floresacton/slc-control/README.md

# slc-control
Display Controller for SLC Kit Car
