floresacton/slc-control/pcb/design-requirements.txt

altitude(pressure sensor) (LPS22HH)
compass sensor (QMC5883L)
gps (standard module)
2 big mosfet switches (N type positive rail)
eeprom memory
1 speed replicate channel (mosfet pull, optional push)
usb-connection
four regular buttons
corner plated mounting holes (through display)
screen connection
3 sensor channels (voltage divider to internal comparator with hysteresis, DAC input)
screw terminals for connections

speed channel(DAC with buffered output)
3d printed case
External Active Antenna
https://www.amazon.com/Waterproof-Active-Antenna-28dB-3-5VDC/dp/B00LXRQY9A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
