floresacton/slc-control/firmware/resource/slc_true.jpg

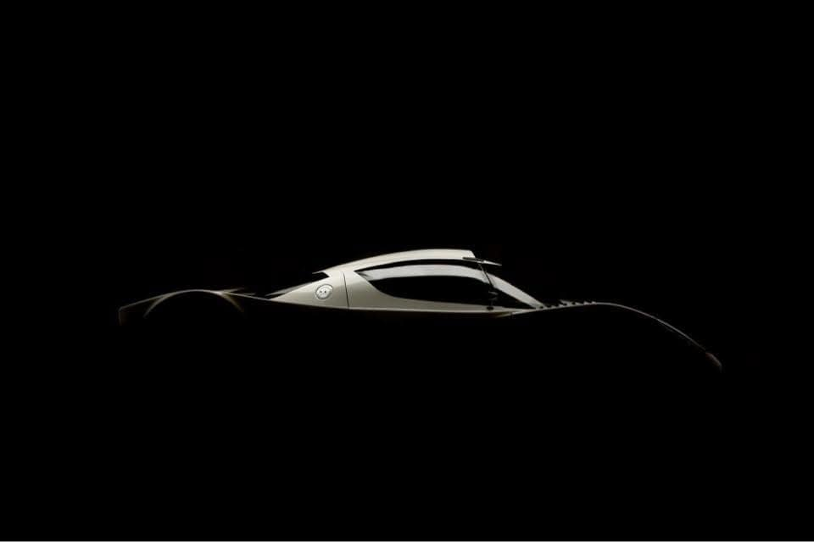
firmware/resource/slc_true.jpg
