floresacton/slc-control/pcb/slc-control.kicad_pcb

## KiCad design pcb/slc-control.kicad_pcb (2025-01-04)

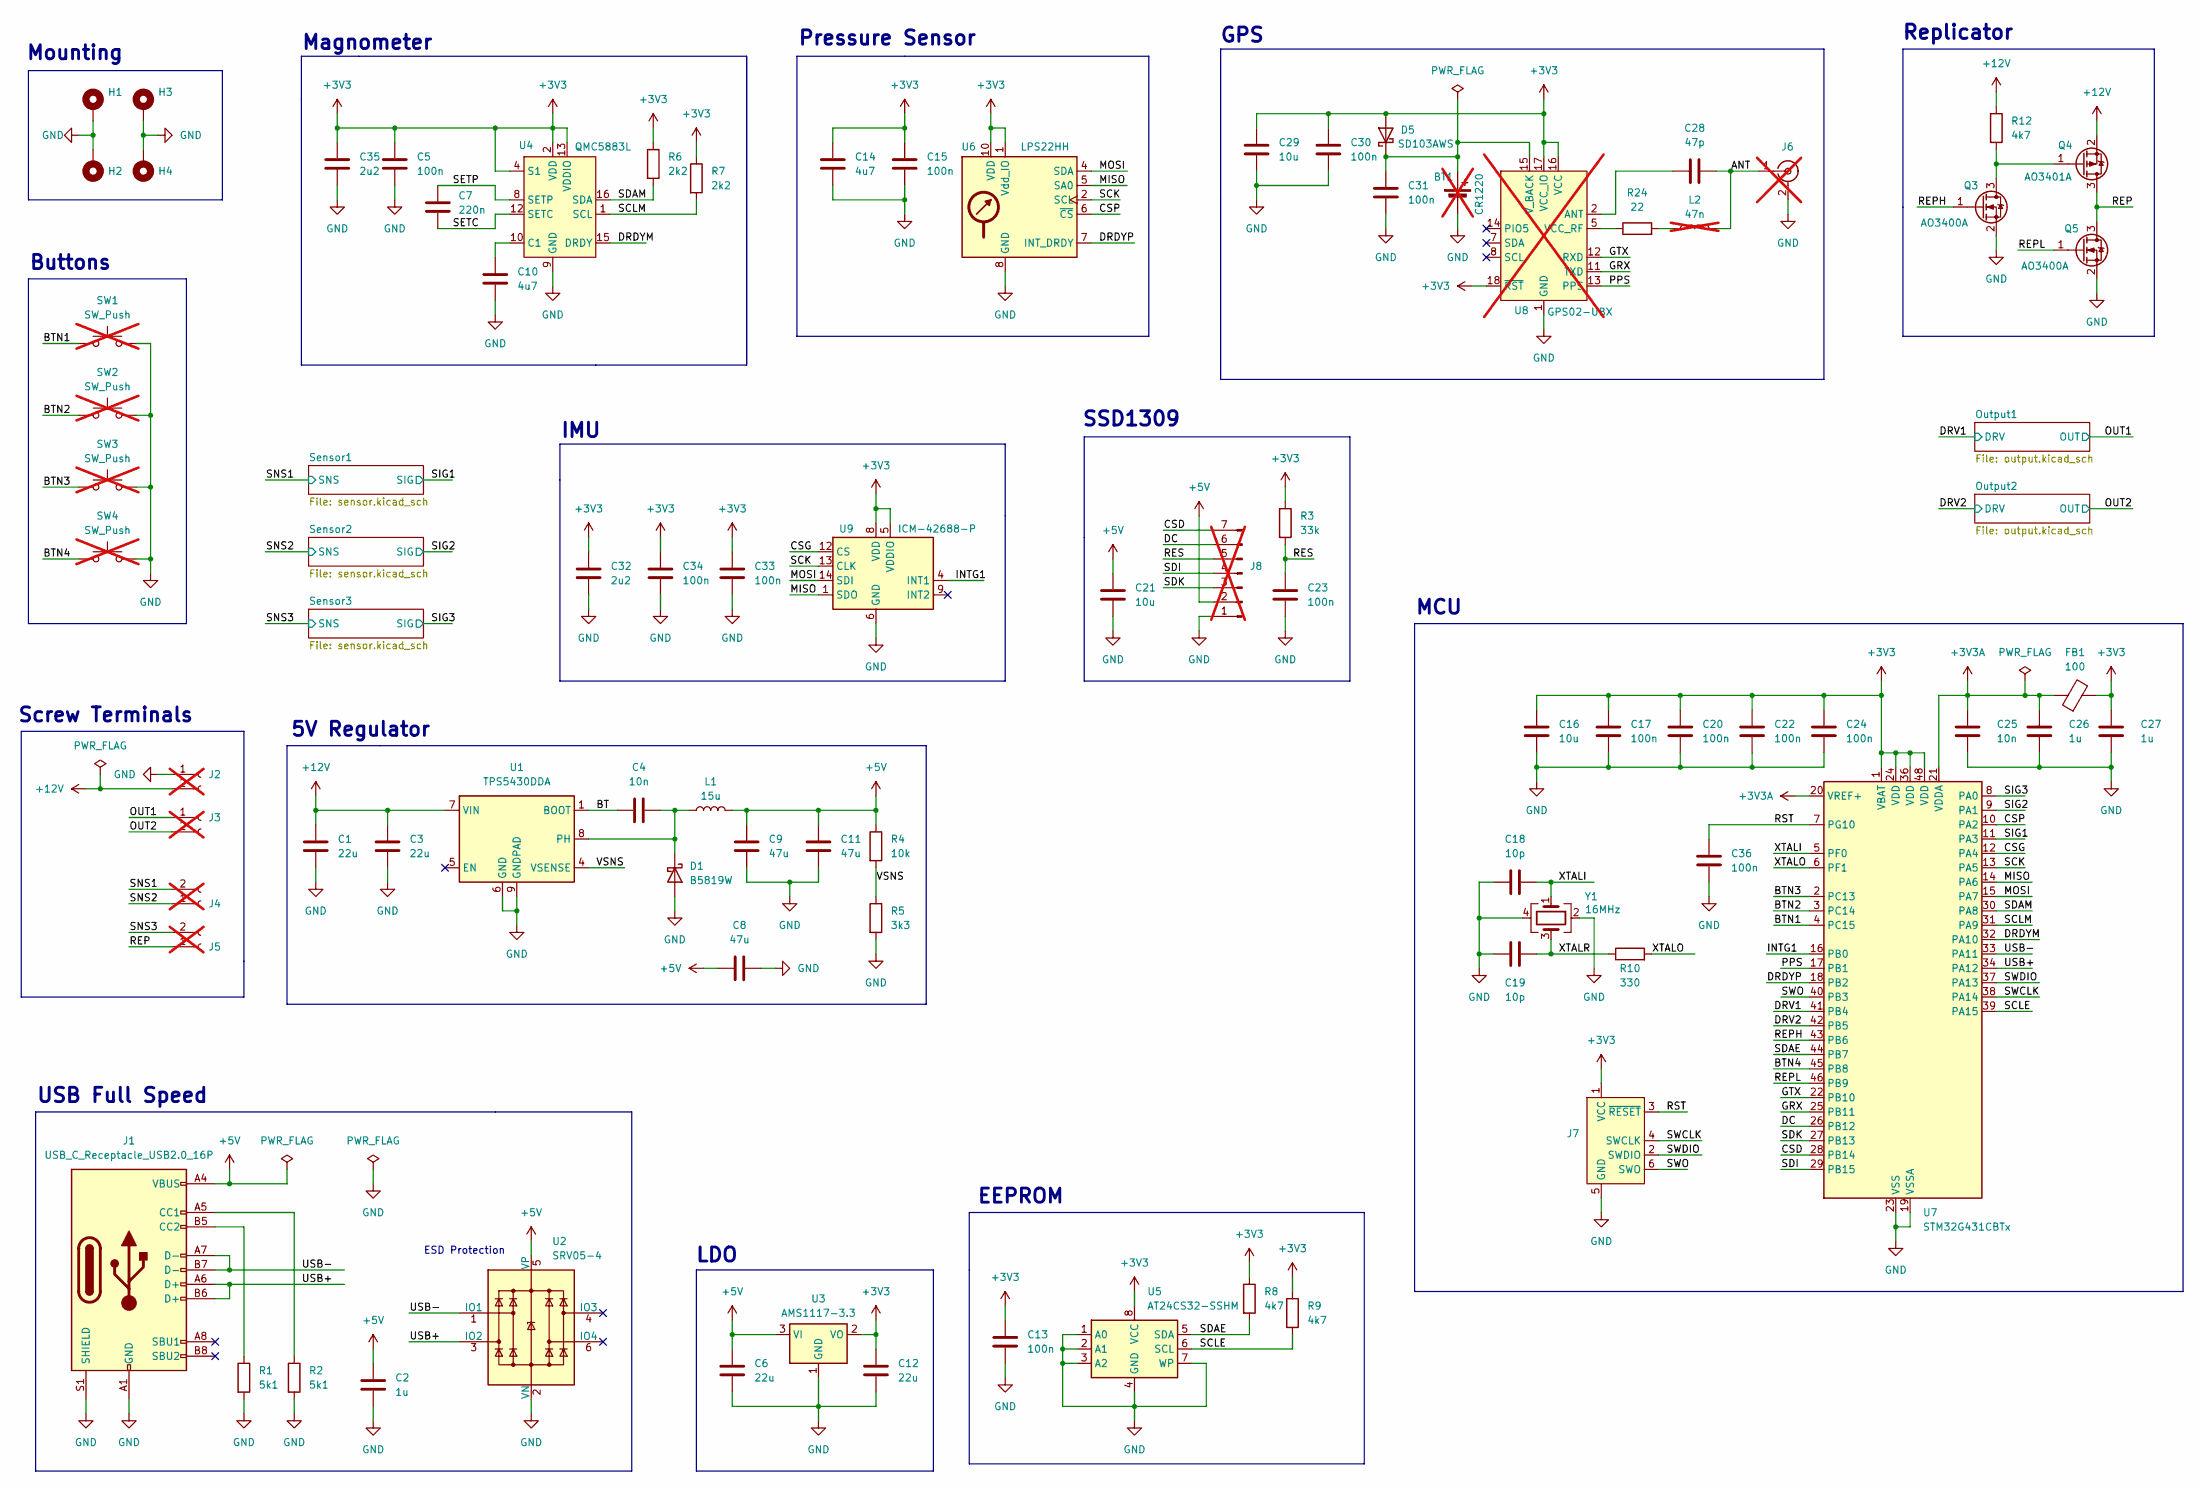
[picture p2: schematic slc-control.kicad_sch]

Parts:
BT1: CR1220; LCSC C70381; not fitted
C1, C3: 22u; C_1206_3216Metric; LCSC C12891
C2, C26, C27: 1u; C_0402_1005Metric; LCSC C52923
C4, C25: 10n; C_0402_1005Metric; LCSC C15195
C5, C13, C15, C17, C20, C22, C23, C24, C30, C31, C33, C34, C36: 100n; C_0402_1005Metric; LCSC C1525
C6: 22u; C_0805_2012Metric; LCSC C45783
C7: 220n; C_0402_1005Metric; LCSC C16772
C8, C9, C11: 47u; C_1206_3216Metric; LCSC C96123
C10: 4u7; C_0603_1608Metric; LCSC C19666
C12: 22u; C_0603_1608Metric; LCSC C59461
C14: 4u7; C_0402_1005Metric; LCSC C23733
C16, C21, C29: 10u; C_0603_1608Metric; LCSC C19702
C18, C19: 10p; C_0402_1005Metric; LCSC C32949
C28: 47p; C_0402_1005Metric; LCSC C1567
C32, C35: 2u2; C_0402_1005Metric; LCSC C12530
D1: B5819W; D_SOD-123; LCSC C8598
D5: SD103AWS; D_SOD-323; LCSC C7420360
FB1: 100; L_0805_2012Metric; LCSC C1015
H1, H2, H3, H4: MountingHole_Pad; MountingHole_5.3mm_M5_ISO7380_Pad
J1: USB_C_Receptacle_USB2.0_16P; USB_C_Receptacle_GCT_USB4105-xx-A_16P_TopMnt_Horizontal; LCSC C2765186
J2, J3, J4, J5: Conn_01x02_Socket; WJ126V-5.0-2P; LCSC C8404; not fitted
J6: Conn_Coaxial; BWSMA-KWE-Z001; LCSC C496551; not fitted
J7: Conn_ARM_SWD_TagConnect_TC2030-NL; Tag-Connect_TC2030-IDC-NL_2x03_P1.27mm_Vertical
J8: Conn_01x07_Pin; PinHeader_1x07_P2.54mm_Vertical; not fitted
L1: 15u; L_Changjiang_FNR6020S; LCSC C168015
L2: 47n; L_0603_1608Metric; LCSC C98076; not fitted
Q3, Q5: AO3400A; SOT-23; LCSC C20917
Q4: AO3401A; SOT-23; LCSC C15127
R1, R2: 5k1; R_0402_1005Metric; LCSC C25905
R3: 33k; R_0402_1005Metric; LCSC C25779
R4: 10k; R_0402_1005Metric; LCSC C25744
R5: 3k3; R_0402_1005Metric; LCSC C25890
R6, R7: 2k2; R_0402_1005Metric; LCSC C25879
R8, R9, R12: 4k7; R_0402_1005Metric; LCSC C25900
R10: 330; R_0402_1005Metric; LCSC C25104
R24: 22; R_0402_1005Metric; LCSC C25092
SW1, SW2, SW3, SW4: SW_Push; SW_PUSH_6mm_H9.5mm; LCSC C455119; not fitted
U1: TPS5430DDA; TI_SO-PowerPAD-8_ThermalVias; LCSC C9864
U2: SRV05-4; SOT-23-6; LCSC C7420376
U3: AMS1117-3.3; SOT-223-3_TabPin2; LCSC C6186
U4: QMC5883L; LGA-16_3x3mm_P0.5mm; LCSC C976032
U5: AT24CS32-SSHM; SOIC-8_3.9x4.9mm_P1.27mm; LCSC C6482
U6: LPS22HH; ST_HLGA-10_2x2mm_P0.5mm_LayoutBorder3x2y; LCSC C2827824
U7: STM32G431CBTx; LQFP-48_7x7mm_P0.5mm; LCSC C529355
U8: GPS02-UBX; LCSC C5356636; not fitted
U9: ICM-42688-P; LGA-14_3x2.5mm_P0.5mm_LayoutBorder3x4y; LCSC C1850418
Y1: 16MHz; Crystal_SMD_3225-4Pin_3.2x2.5mm; LCSC C13738

Connections:
+3V3: C5.1, C12.1, C13.1, C14.1, C15.1, C16.1, C17.1, C20.1, C22.1, C24.1, C27.1, C29.1, C30.1, C32.1, C33.1, C34.1, C35.1, D5.2 (A), FB1.2, J7.1 (VCC), R3.1, R6.1, R7.1, R8.1, R9.1, U3.2 (VO), U4.2 (VDD), U4.4 (S1), U4.13 (VDDIO), U5.8 (VCC), U6.1 (Vdd_IO), U6.10 (VDD), U7.1 (VBAT), U7.24 (VDD), U7.36 (VDD), U7.48 (VDD), U8.16 (VCC), U8.17 (VCC_IO), U8.18 (~RST), U9.5 (VDDIO), U9.8 (VDD)
+3V3A: C25.1, C26.1, FB1.1, U7.20 (VREF+), U7.21 (VDDA)
+5V: C2.1, C6.1, C8.1, C9.1, C11.1, C21.1, J1.A4 (VBUS), J1.A9 (VBUS), J1.B4 (VBUS), J1.B9 (VBUS), J8.2, L1.2, R4.1, U2.5 (VP), U3.3 (VI)
+12V: C1.1, C3.1, J2.2, Q4.2 (S), R12.1, U1.7 (VIN); also elsewhere on the board
/ANT: C28.2, J6.1 (In), L2.2
/BT: C4.1, U1.1 (BOOT)
/BTN1: SW1.1, U7.4 (PC15)
/BTN2: SW2.1, U7.3 (PC14)
/BTN3: SW3.1, U7.2 (PC13)
/BTN4: SW4.1, U7.45 (PB8)
/CSD: J8.7, U7.28 (PB14)
/CSG: U7.12 (PA4), U9.12 (CS)
/CSP: U6.6 (~CS), U7.10 (PA2)
/DC: J8.6, U7.26 (PB12)
/DRDYM: U4.15 (DRDY), U7.32 (PA10)
/DRDYP: U6.7 (INT_DRDY), U7.18 (PB2)
/DRV1: U7.41 (PB4); also elsewhere on the board
/DRV2: U7.42 (PB5); also elsewhere on the board
/GRX: U7.25 (PB11), U8.11 (TXD)
/GTX: U7.22 (PB10), U8.12 (RXD)
/INTG1: U7.16 (PB0), U9.4 (INT1)
/MISO: U6.5 (SA0), U7.14 (PA6), U9.1 (SDO)
/MOSI: U6.4 (SDA), U7.15 (PA7), U9.14 (SDI)
/OUT1: J3.1; also elsewhere on the board
/OUT2: J3.2; also elsewhere on the board
/PPS: U7.17 (PB1), U8.13 (PPS)
/REP: J5.1, Q4.3 (D), Q5.3 (D)
/REPH: Q3.1 (G), U7.43 (PB6)
/REPL: Q5.1 (G), U7.46 (PB9)
/RES: C23.1, J8.5, R3.2
/RST: C36.1, J7.3 (~RESET), U7.7 (PG10)
/SCK: U6.2 (SCL), U7.13 (PA5), U9.13 (CLK)
/SCLE: R9.2, U5.6 (SCL), U7.39 (PA15)
/SCLM: R7.2, U4.1 (SCL), U7.31 (PA9)
/SDAE: R8.2, U5.5 (SDA), U7.44 (PB7)
/SDAM: R6.2, U4.16 (SDA), U7.30 (PA8)
/SDI: J8.4, U7.29 (PB15)
/SDK: J8.3, U7.27 (PB13)
/SETC: C7.2, U4.12 (SETC)
/SETP: C7.1, U4.8 (SETP)
/SIG1: U7.11 (PA3); also elsewhere on the board
/SIG2: U7.9 (PA1); also elsewhere on the board
/SIG3: U7.8 (PA0); also elsewhere on the board
/SNS1: J4.2; also elsewhere on the board
/SNS2: J4.1; also elsewhere on the board
/SNS3: J5.2; also elsewhere on the board
/SWCLK: J7.4 (SWCLK), U7.38 (PA14)
/SWDIO: J7.2 (SWDIO), U7.37 (PA13)
/SWO: J7.6 (SWO), U7.40 (PB3)
/USB+: J1.A6 (D+), J1.B6 (D+), U2.3 (IO2), U7.34 (PA12)
/USB-: J1.A7 (D-), J1.B7 (D-), U2.1 (IO1), U7.33 (PA11)
/VSNS: R4.2, R5.1, U1.4 (VSENSE)
/XTALI: C18.2, U7.5 (PF0), Y1.1
/XTALO: R10.2, U7.6 (PF1)
/XTALR: C19.2, R10.1, Y1.3
GND: BT1.2 (-), C1.2, C2.2, C3.2, C5.2, C6.2, C8.2, C9.2, C10.2, C11.2, C12.2, C13.2, C14.2, C15.2, C16.2, C17.2, C18.1, C19.1, C20.2, C21.2, C22.2, C23.2, C24.2, C25.2, C26.2, C27.2, C29.2, C30.2, C31.2, C32.2, C33.2, C34.2, C35.2, C36.2, D1.2 (A), H1.1, H2.1, H3.1, H4.1, J1.A1 (GND), J1.A12 (GND), J1.B1 (GND), J1.B12 (GND), J1.S1 (SHIELD), J2.1, J6.2 (Ext), J7.5 (GND), J8.1, Q3.2 (S), Q5.2 (S), R1.2, R2.2, R5.2, SW1.2, SW2.2, SW3.2, SW4.2, U1.6 (GND), U1.9 (GNDPAD), U2.2 (VN), U3.1 (GND), U4.9 (GND), U4.11 (GND), U5.1 (A0), U5.2 (A1), U5.3 (A2), U5.4 (GND), U5.7 (WP), U6.3 (GND), U6.8 (GND), U6.9 (GND), U7.19 (VSSA), U7.23 (VSS), U7.35 (VSS), U7.47 (VSS), U8.1 (GND), U8.3 (GND), U8.10 (GND), U9.6 (GND), U9.7 (RESV), U9.11 (RESV), Y1.2, Y1.4; also elsewhere on the board
unnamed: BT1.1 (+), C31.1, D5.1 (K), U8.15 (V_BACK)
unnamed: C4.2, D1.1 (K), L1.1, U1.8 (PH)
unnamed: J1.A5 (CC1), R2.1
unnamed: J1.B5 (CC2), R1.1
unnamed: L2.1, R24.2
unnamed: Q3.3 (D), Q4.1 (G), R12.2
unnamed: C10.1, U4.10 (C1)
unnamed: C28.1, U8.2 (ANT)
unnamed: R24.1, U8.5 (VCC_RF)

Notes on the sheet:
5V Regulator
Mounting
USB Full Speed
Buttons
Magnometer
Screw Terminals
ESD Protection
GPS
SSD1309
Pressure Sensor
IMU
Replicator
LDO
MCU
EEPROM

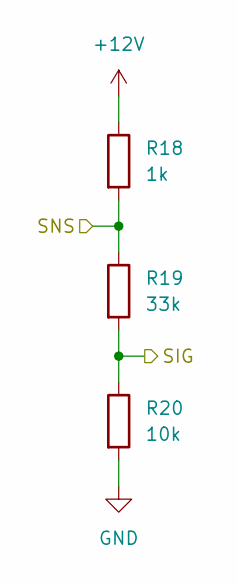
[picture p3: schematic sensor.kicad_sch]

Parts:
R18: 1k; R_1206_3216Metric; LCSC C4410
R19: 33k; R_0402_1005Metric; LCSC C25779
R20: 10k; R_0402_1005Metric; LCSC C25744

Connections:
+12V: R18.1; also elsewhere on the board
/SIG2: R19.2, R20.1; also elsewhere on the board
/SNS2: R18.2, R19.1; also elsewhere on the board
GND: R20.2; also elsewhere on the board

Parts of its further copies:
R15, R21: 1k; R_1206_3216Metric; LCSC C4410
R16, R22: 33k; R_0402_1005Metric; LCSC C25779
R17, R23: 10k; R_0402_1005Metric; LCSC C25744

Connections of its further copies:
+12V: R15.1, R21.1; also elsewhere on the board
/SIG1: R16.2, R17.1; also elsewhere on the board
/SIG3: R22.2, R23.1; also elsewhere on the board
/SNS1: R15.2, R16.1; also elsewhere on the board
/SNS3: R21.2, R22.1; also elsewhere on the board
GND: R17.2, R23.2; also elsewhere on the board

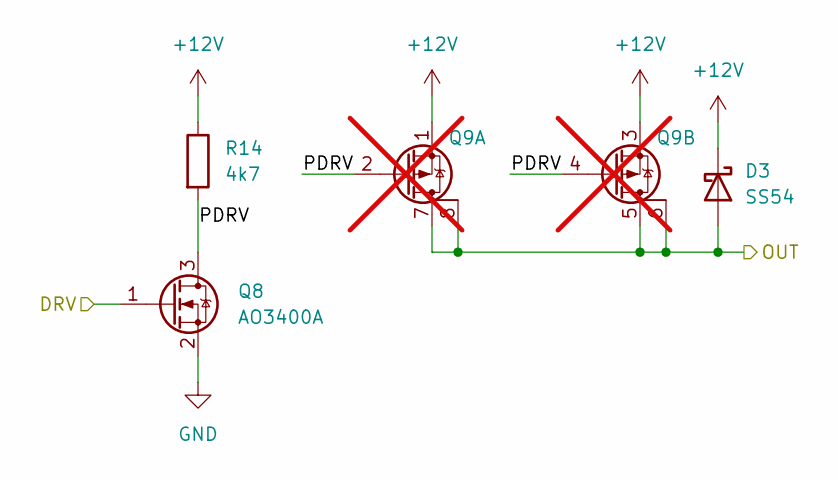
[picture p4: schematic output.kicad_sch]

Parts:
D3: SS54; D_SMA; LCSC C22452
Q8: AO3400A; SOT-23; LCSC C20917
Q9: Q_Dual_PMOS_S1G1S2G2D2D2D1D1; SO-8_3.9x4.9mm_P1.27mm; LCSC C725015; not fitted
R14: 4k7; R_0402_1005Metric; LCSC C25900

Connections:
+12V: D3.1 (K), Q9.1 (S), Q9.3 (S), R14.1; also elsewhere on the board
/DRV2: Q8.1 (G); also elsewhere on the board
/OUT2: D3.2 (A), Q9.5 (D), Q9.6 (D), Q9.7 (D), Q9.8 (D); also elsewhere on the board
/Output2/PDRV: Q8.3 (D), Q9.2 (G), Q9.4 (G), R14.2
GND: Q8.2 (S); also elsewhere on the board

Parts of its further copies:
D2: SS54; D_SMA; LCSC C22452
Q6: AO3400A; SOT-23; LCSC C20917
Q7: Q_Dual_PMOS_S1G1S2G2D2D2D1D1; SO-8_3.9x4.9mm_P1.27mm; LCSC C725015; not fitted
R13: 4k7; R_0402_1005Metric; LCSC C25900

Connections of its further copies:
+12V: D2.1 (K), Q7.1 (S), Q7.3 (S), R13.1; also elsewhere on the board
/DRV1: Q6.1 (G); also elsewhere on the board
/OUT1: D2.2 (A), Q7.5 (D), Q7.6 (D), Q7.7 (D), Q7.8 (D); also elsewhere on the board
/Output1/PDRV: Q6.3 (D), Q7.2 (G), Q7.4 (G), R13.2
GND: Q6.2 (S); also elsewhere on the board

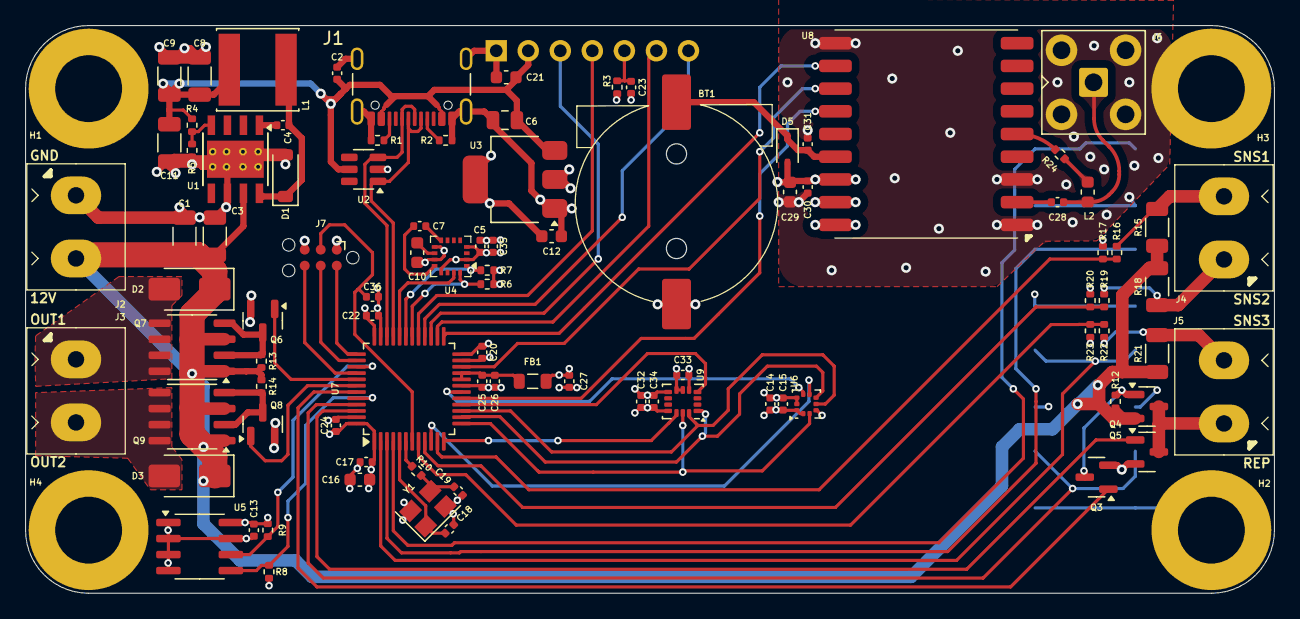
[picture p5: board slc-control.kicad_pcb from above]

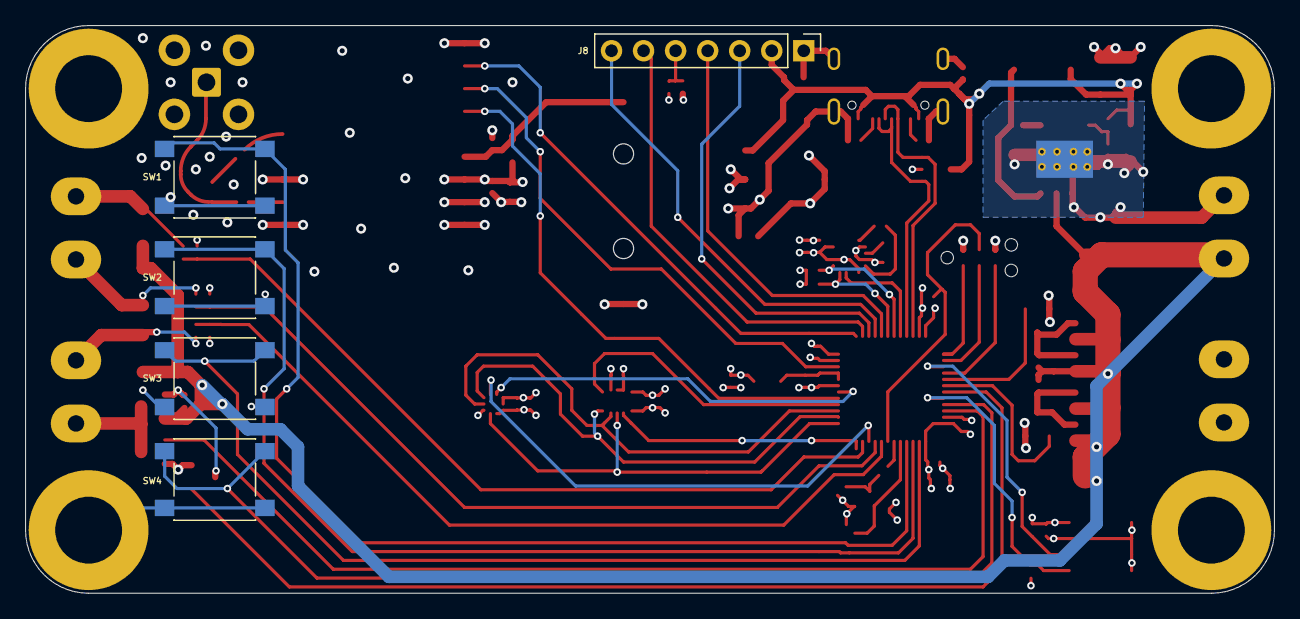
[picture p6: board slc-control.kicad_pcb from below]

Board: 4 copper layers, 99.0 x 45.0 mm, 100 parts (5 on the bottom side), 67 nets.
