floresacton/slc-control/firmware/slc-control/slc-control.ioc

Mcu.UserName=STM32G431CBTx
PA0.GPIO_Label=SIG3
PA0.Signal=COMP3_INP
PA1.GPIO_Label=SIG2
PA1.Signal=COMP1_INP
PA10.GPIO_Label=DRDYM
PA10.Signal=GPXTI10
PA11.Signal=USB_DM
PA12.Signal=USB_DP
PA13.Signal=SYS_JTMS-SWDIO
PA14.Signal=SYS_JTCK-SWCLK
PA15.Signal=I2C1_SCL
PA2.GPIO_Label=CSP
PA2.Signal=GPIO_Output
PA3.GPIO_Label=SIG1
PA3.Signal=COMP2_INP
PA4.GPIO_Label=CSG
PA4.Signal=GPIO_Output
PA5.GPIO_Label=SCKM
PA5.Signal=SPI1_SCK
PA6.GPIO_Label=MISOM
PA6.Signal=SPI1_MISO
PA7.GPIO_Label=MOSIM
PA7.Signal=SPI1_MOSI
PA8.Signal=I2C2_SDA
PA9.Signal=I2C2_SCL
PB0.GPIO_Label=INTG
PB0.Signal=GPXTI0
PB1.GPIO_Label=PPS
PB1.Signal=GPXTI1
PB10.GPIO_Label=GTX
PB10.Signal=USART3_TX
PB11.GPIO_Label=GRX
PB11.Signal=USART3_RX
PB12.GPIO_Label=DC
PB12.Signal=GPIO_Output
PB13.GPIO_Label=SCKD
PB13.Signal=SPI2_SCK
PB14.GPIO_Label=CSD
PB14.Signal=GPIO_Output
PB15.GPIO_Label=MOSID
PB15.Signal=SPI2_MOSI
PB2.GPIO_Label=DRDYP
PB2.Signal=GPXTI2
PB3.Signal=SYS_JTDO-SWO
PB4.GPIO_Label=DRV1
PB4.Signal=GPIO_Output
PB5.GPIO_Label=DRV2
PB5.Signal=GPIO_Output
PB6.Signal=S_TIM8_CH1
PB7.Signal=I2C1_SDA
PB8-BOOT0.GPIO_Label=BTN4
PB8-BOOT0.Signal=GPIO_Input
PC13.GPIO_Label=BTN3
PC13.Signal=GPIO_Input
PC14-OSC32_IN.GPIO_Label=BTN2
PC14-OSC32_IN.Signal=GPIO_Input
PC15-OSC32_OUT.GPIO_Label=BTN1
PC15-OSC32_OUT.Signal=GPIO_Input
PF0-OSC_IN.Signal=RCC_OSC_IN
PF1-OSC_OUT.Signal=RCC_OSC_OUT
