floresacton/slc-control/firmware/slc-control/Core/Inc/main.h

#define BTN3_Pin GPIO_PIN_13
#define BTN3_GPIO_Port GPIOC
#define BTN2_Pin GPIO_PIN_14
#define BTN2_GPIO_Port GPIOC
#define BTN1_Pin GPIO_PIN_15
#define BTN1_GPIO_Port GPIOC
#define SIG3_Pin GPIO_PIN_0
#define SIG3_GPIO_Port GPIOA
#define SIG2_Pin GPIO_PIN_1
#define SIG2_GPIO_Port GPIOA
#define CSP_Pin GPIO_PIN_2
#define CSP_GPIO_Port GPIOA
#define SIG1_Pin GPIO_PIN_3
#define SIG1_GPIO_Port GPIOA
#define CSG_Pin GPIO_PIN_4
#define CSG_GPIO_Port GPIOA
#define SCKM_Pin GPIO_PIN_5
#define SCKM_GPIO_Port GPIOA
#define MISOM_Pin GPIO_PIN_6
#define MISOM_GPIO_Port GPIOA
#define MOSIM_Pin GPIO_PIN_7
#define MOSIM_GPIO_Port GPIOA
#define INTG_Pin GPIO_PIN_0
#define INTG_GPIO_Port GPIOB
#define PPS_Pin GPIO_PIN_1
#define PPS_GPIO_Port GPIOB
#define DRDYP_Pin GPIO_PIN_2
#define DRDYP_GPIO_Port GPIOB
#define GTX_Pin GPIO_PIN_10
#define GTX_GPIO_Port GPIOB
#define GRX_Pin GPIO_PIN_11
#define GRX_GPIO_Port GPIOB
#define DC_Pin GPIO_PIN_12
#define DC_GPIO_Port GPIOB
#define SCKD_Pin GPIO_PIN_13
#define SCKD_GPIO_Port GPIOB
#define CSD_Pin GPIO_PIN_14
#define CSD_GPIO_Port GPIOB
#define MOSID_Pin GPIO_PIN_15
#define MOSID_GPIO_Port GPIOB
#define DRDYM_Pin GPIO_PIN_10
#define DRDYM_GPIO_Port GPIOA
#define DRV1_Pin GPIO_PIN_4
#define DRV1_GPIO_Port GPIOB
#define DRV2_Pin GPIO_PIN_5
#define DRV2_GPIO_Port GPIOB
#define BTN4_Pin GPIO_PIN_8
#define BTN4_GPIO_Port GPIOB
