floresacton/slc-control/firmware/slc-control/App/Inc/bitmap.h

#ifndef INC_BITMAP_H_
#define INC_BITMAP_H_

#include "stdint.h"

extern const uint8_t Bitmap_Logo[];
extern const uint8_t Bitmap_Scroll[];
extern const uint8_t Bitmap_Edit[];
extern const uint8_t Bitmap_NoSignal[];
extern const uint8_t Bitmap_Signal[];
extern const uint8_t Bitmap_Decimal[];
extern const uint8_t Bitmap_Forward[];
extern const uint8_t Bitmap_Lateral[];

#endif
