floresacton/slc-control/firmware/slc-control/App/Src/bitmap.c

#include "bitmap.h"
#include "inttypes.h"

const unsigned char Bitmap_Logo[] = {
	0x00, 0x00, 0x00, 0x00, 0x00, 0x3f, 0xe0, 0x00, 0x00, 0x00, 0x00, 0x00, 0x00, 0x00, 0x00, 0x00, 
	0x0f, 0xff, 0xd8, 0x00, 0x00, 0x00, 0x00, 0x00, 0x00, 0x00, 0x00, 0x00, 0xfc, 0x00, 0x00, 0x00, 
	0x00, 0x00, 0x00, 0x00, 0x00, 0x00, 0x00, 0x07, 0xff, 0xff, 0xfe, 0x00, 0x00, 0x00, 0x00, 0x00, 
	0x00, 0x00, 0x00, 0x03, 0xfc, 0x00, 0x03, 0x00, 0x00, 0x00, 0x00, 0x00, 0x00, 0x00, 0x00, 0x3f, 
	0xf0, 0x00, 0x00, 0xc0, 0x00, 0x00, 0x00, 0x00, 0x83, 0xfe, 0x03, 0xff, 0xf8, 0x00, 0x00, 0x30, 
	0x00, 0x00, 0x00, 0x00, 0xfc, 0x01, 0xff, 0xff, 0xfe, 0x00, 0x00, 0x18, 0x00, 0x00, 0x00, 0x00, 
	0x80, 0x00, 0x08, 0xff, 0xff, 0xff, 0x00, 0x06, 0x3f, 0xe0, 0x00, 0x00, 0x80, 0xf8, 0x00, 0x00, 
	0x7f, 0xff, 0xff, 0xff, 0xc0, 0x1c, 0x00, 0x00, 0x83, 0x06, 0x00, 0x00, 0x00, 0x00, 0x01, 0xc0, 
	0x03, 0xff, 0x80, 0x00, 0x84, 0x01, 0x00, 0x00, 0x00, 0x00, 0x00, 0x00, 0x0c, 0x0c, 0x60, 0x00, 
	0x88, 0x00, 0x80, 0x00, 0x00, 0x00, 0x00, 0x00, 0x10, 0x02, 0x18, 0x00, 0x48, 0x00, 0x80, 0x00, 
	0x00, 0x00, 0x00, 0x00, 0x20, 0x01, 0x04, 0x00, 0x50, 0x00, 0x40, 0x00, 0x00, 0x00, 0x00, 0x00, 
	0x20, 0x00, 0x83, 0x00, 0x50, 0x00, 0x40, 0x00, 0x00, 0x00, 0x00, 0x00, 0x20, 0x00, 0x80, 0x80
};

const uint8_t Bitmap_Scroll[] = { 0xfc, 0x84, 0x84, 0x84, 0x84, 0x84, 0x84, 0x84,
        0x84, 0x84, 0x84, 0x84, 0x84, 0x84, 0x84, 0x84, 0x84, 0x84, 0x84, 0x84,
        0x84, 0x84, 0x84, 0x84, 0x84, 0x84, 0x84, 0x84, 0x84, 0x84, 0x84, 0x84,
        0x84, 0x84, 0x84, 0x84, 0x84, 0x84, 0x84, 0x84, 0x84, 0x84, 0x84, 0x84,
        0x84, 0x84, 0x84, 0xfc };

const uint8_t Bitmap_Edit[] = {
        0xFE,
        0x82,
};

const uint8_t Bitmap_NoSignal[] = {0xbd, 0x42, 0xa5, 0x99, 0x99, 0xa5, 0x42, 0xbd};

const uint8_t Bitmap_Signal[] = {0x3c, 0x42, 0x99, 0xbd, 0xbd, 0x99, 0x42, 0x3c};

const uint8_t Bitmap_Decimal[] = {0x40, 0xE0, 0x40};

const uint8_t Bitmap_Forward[] = {0x38, 0x54, 0x92, 0x10, 0x10, 0x92, 0x54, 0x38};

const uint8_t Bitmap_Lateral[] = {0x24, 0x42, 0x81, 0xFF, 0x81, 0x42, 0x24};
