floresacton/slc-control/firmware/slc-control/App/Src/memory.c

#include "memory.h"
#include "eeprom.h"
#include "stdlib.h"
#include "stdbool.h"
#include "str.h"

void Memory_Init(struct Memory_Handle* handle) {
    for (uint8_t i = 0; i < handle->count; i++) {
        struct Memory_Variable* var = handle->vars[i];
        var->address = 4 * (i + 1);

        float value = var->max;
        int8_t digit = -1;
        while (value >= 1) {
            value /= 10.0f;
            digit++;
        }
        var->maxDigit = digit;
    }

    float hash;
    Eeprom_Read(handle->eeprom, 0, (uint8_t*)&hash, 4);
    HAL_Delay(10);
    if (hash != handle->hash) {
        Eeprom_Write(handle->eeprom, 0, (uint8_t*)&handle->hash, 4);
        HAL_Delay(10);
        Memory_Reset(handle);
    }else{
        float buf[handle->count];
        Eeprom_Read(handle->eeprom, 4, (uint8_t*)buf, handle->count*4);
        HAL_Delay(100);
        for (uint8_t i = 0; i < handle->count; i++) {
            handle->vars[i]->value = buf[i];
        }
    }
}

void Memory_Reset(struct Memory_Handle* handle) {
    for (uint8_t i = 0; i < handle->count; i++) {
        struct Memory_Variable* var = handle->vars[i];
        Eeprom_Write(handle->eeprom, var->address, (uint8_t*)&var->reset, 4);
        HAL_Delay(10);
        var->value = var->reset;
    }
}

void Memory_Save(struct Memory_Handle* handle, struct Memory_Variable* var) {
    Eeprom_Write(handle->eeprom, var->address, (uint8_t*)&var->value, 4);
}

uint8_t Memory_Print(char* buf, struct Memory_Variable* var) {
    const uint8_t len = var->maxDigit + var->decimals + 1;
    Str_PrintFloat(buf, len, var->decimals, true, var->value);
    return len;
}
