floresacton/slc-control/(commit log)

2025-01-04 Configure project
    [bom.csv, designators.csv, gps_config.txt, output.kicad_sch, positions.csv, sensor.kicad_sch, slc-control.kicad_pcb, slc-control.kicad_sch]
2025-07-26 Fix magnometer and pressure
    [app.c, slc-control.ioc]
2025-08-06 Finish accelerometer
2025-08-06 Fix gps interrupt issues
    [app.c, gps.c, gps.h, slc-control.ioc]
2025-08-06 Fix oled font scaling
    [oled.c]
2025-08-19 Fix gps text and accels
    [app.c, icm42688.c]
