floresacton/slc-control/(notices)

Notices in the files:
firmware/slc-control/Core/Inc/main.h:
Copyright (c) 2025 STMicroelectronics.
All rights reserved.
This software is licensed under terms that can be found in the LICENSE file
